MathiasHi/OPENCHESSBOARD_WiFi/schematic/Chessboard/Chessboard_top.jpg

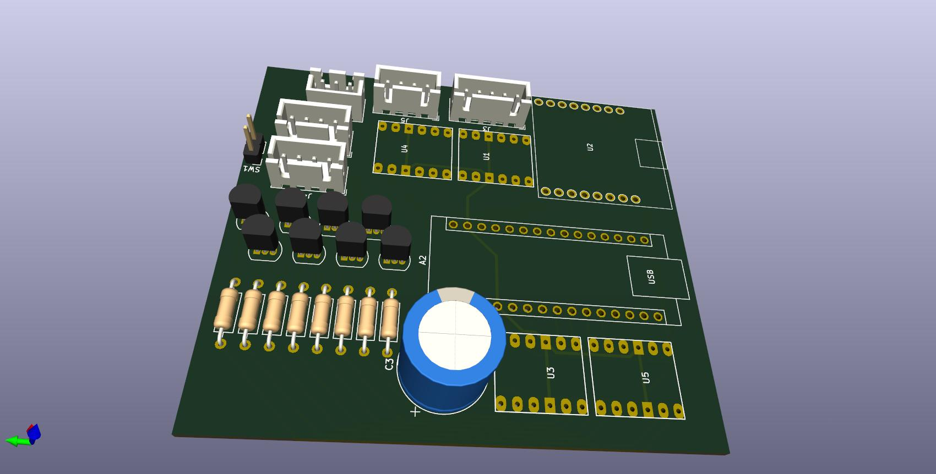
schematic/Chessboard/Chessboard_top.jpg
