MathiasHi/OPENCHESSBOARD_WiFi/schematic/Chessboard/Chessboard_bottom.jpg

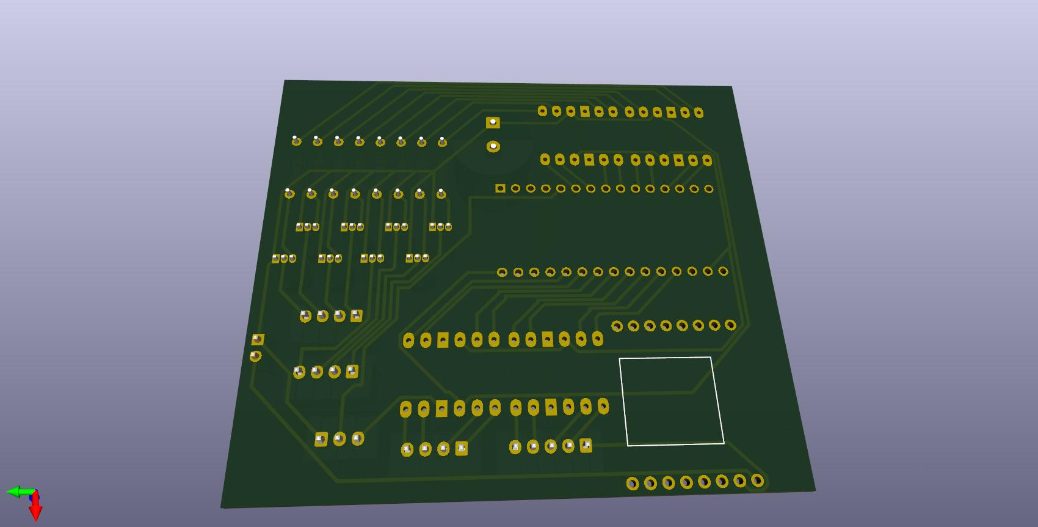
schematic/Chessboard/Chessboard_bottom.jpg
