MathiasHi/OPENCHESSBOARD_WiFi/schematic/ChessfieldLeftIn/Chessfield.kicad_pcb

## KiCad design schematic/ChessfieldLeftIn/Chessfield.kicad_pcb (2025-10-26)

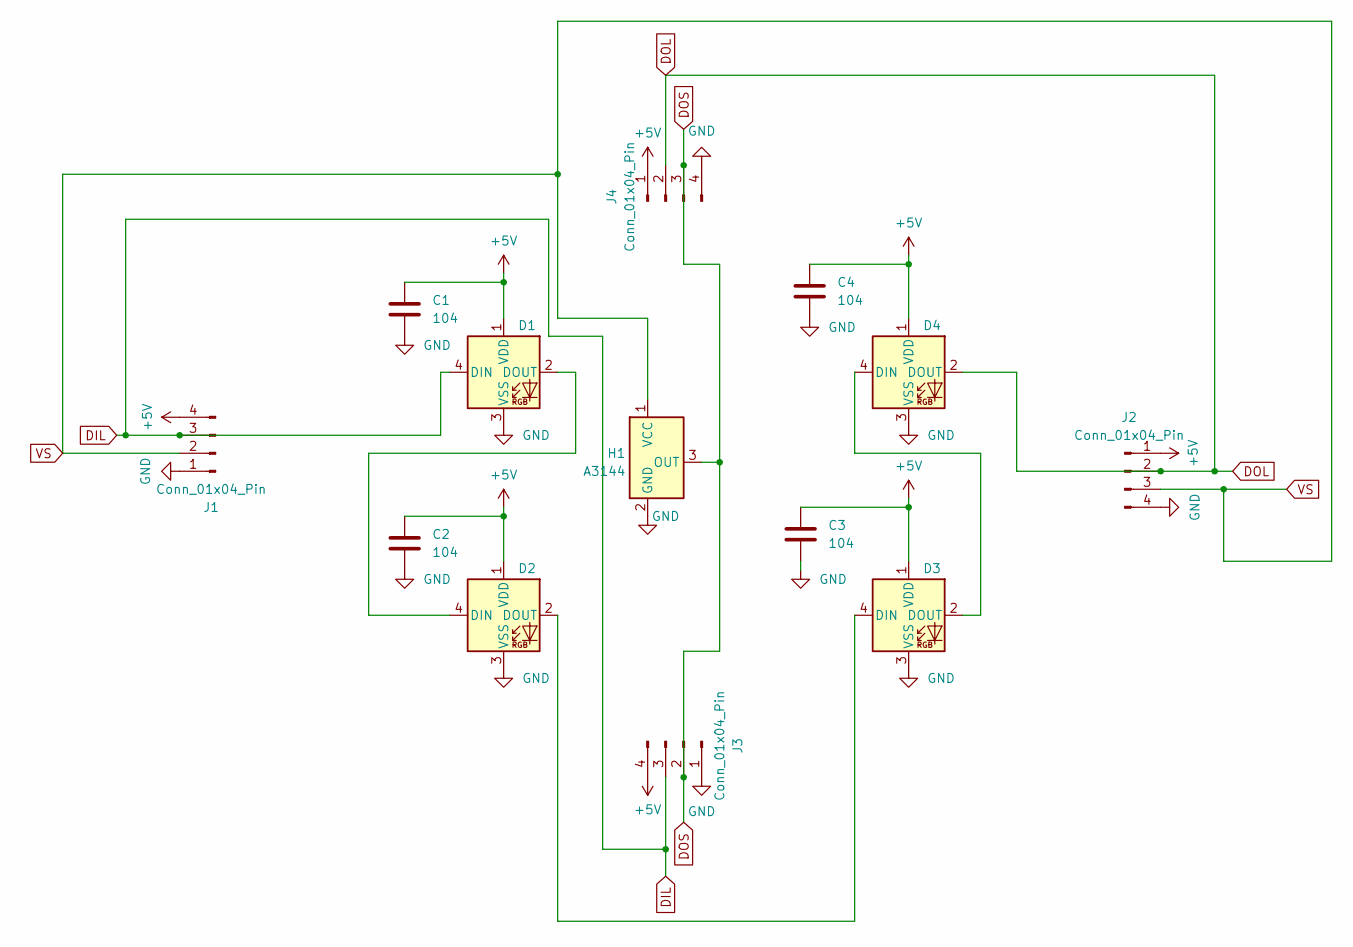
[picture p3: schematic Chessfield.kicad_sch]

Parts:
C1, C2, C3, C4: 104; C_0603_1608Metric_Pad1.08x0.95mm_HandSolder
D1, D2, D3, D4: WS2812B; LED_WS2812B_PLCC4_5.0x5.0mm_P3.2mm
H1: A3144; TO-92_Inline_Horizontal1
J1, J2, J3, J4: Conn_01x04_Pin; PinHeader_1x04_P2.54mm_Horizontal

Connections:
+5V: C1.1, C2.1, C3.1, C4.1, D1.1 (VDD), D2.1 (VDD), D3.1 (VDD), D4.1 (VDD), J1.4, J2.1, J3.4, J4.1
DIL: D1.4 (DIN), J1.3, J3.3
DOL: D4.2 (DOUT), J2.2, J4.2
DOS: H1.3 (OUT), J3.2, J4.3
GND: C1.2, C2.2, C3.2, C4.2, D1.3 (VSS), D2.3 (VSS), D3.3 (VSS), D4.3 (VSS), H1.2 (GND), J1.1, J2.4, J3.1, J4.4
unnamed: D1.2 (DOUT), D2.4 (DIN)
unnamed: D2.2 (DOUT), D3.4 (DIN)
unnamed: D3.2 (DOUT), D4.4 (DIN)
VS: H1.1 (VCC), J1.2, J2.3

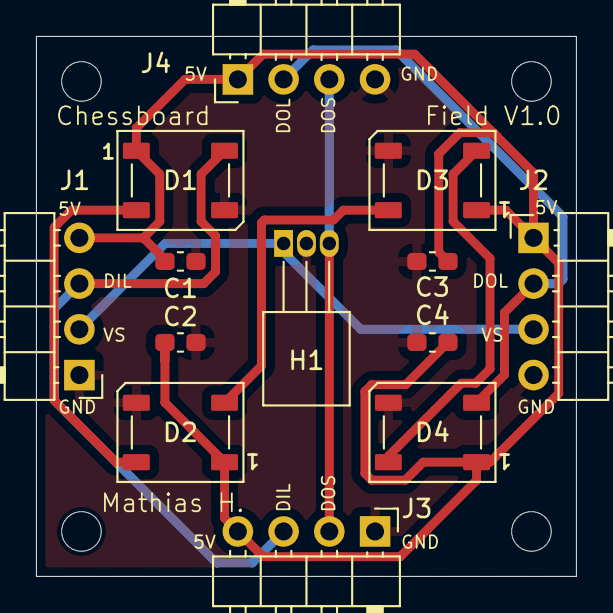
[picture p4: board Chessfield.kicad_pcb from above]

Board: 2 copper layers, 30.0 x 30.0 mm, 13 parts (0 on the bottom side), 9 nets.
