MathiasHi/OPENCHESSBOARD_WiFi/schematic/Chessboard/Chessboard.kicad_pcb

## KiCad design schematic/Chessboard/Chessboard.kicad_pcb (2025-10-26)

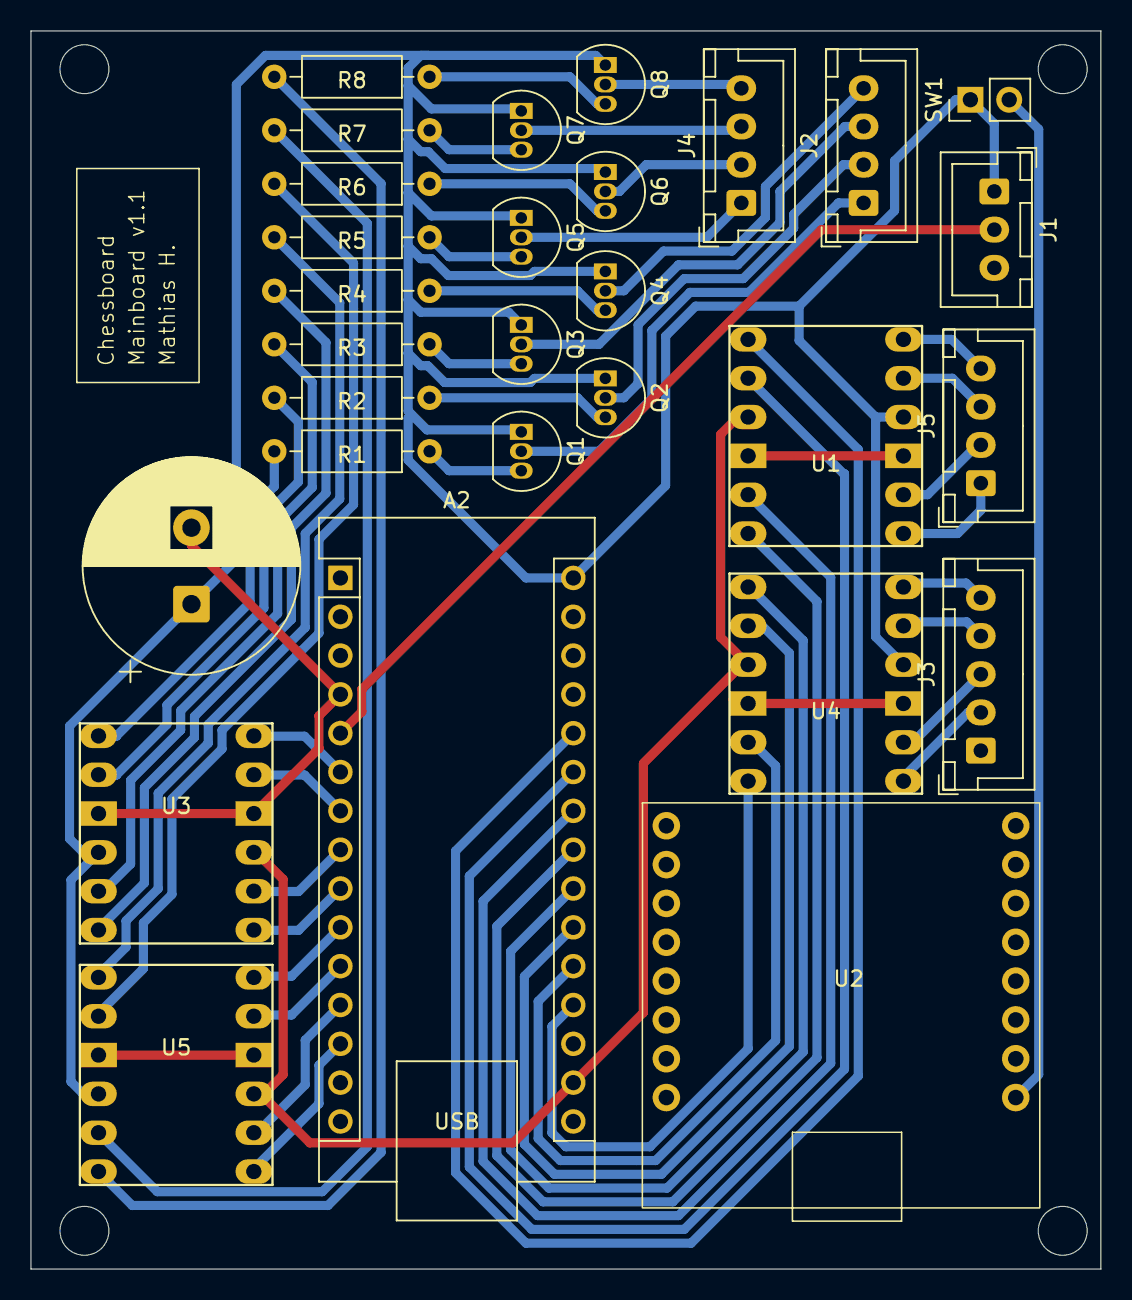
[picture p5: board Chessboard.kicad_pcb from above]

Board: 2 copper layers, 70.0 x 81.0 mm, 29 parts (0 on the bottom side), 53 nets.

Parts:
A2: Arduino_Nano_ESP32; Arduino_Nano
C3: C_Polarized; CP_Radial_D14.0mm_P5.00mm
J1: LED; JST_XH_B3B-XH-A_1x03_P2.50mm_Vertical
J2, J4: VOUT; JST_XH_B4B-XH-A_1x04_P2.50mm_Vertical
J3: Data; JST_XH_B5B-XH-A_1x05_P2.50mm_Vertical
J5: Data; JST_XH_B4B-XH-A_1x04_P2.50mm_Vertical
Q1, Q2, Q3, Q4, Q5, Q6, Q7, Q8: BC640; TO-92_Inline
R1, R2, R3, R4, R5, R6, R7, R8: 2K2; R_Axial_DIN0207_L6.3mm_D2.5mm_P10.16mm_Horizontal
SW1: SW_SPST; PinHeader_1x02_P2.54mm_Vertical
U1, U3, U4, U5: Logic Level Shifter; LogicLevel4ch
U2: Batterie Shield; D1_mini_board

Connections:
+3V3: A2.17 (3V3), U1.10 (LV), U3.10 (LV), U4.10 (LV), U5.10 (LV)
+5V: A2.30 (VIN), C3.1, J1.1, Q1.1 (E), Q2.1 (E), Q3.1 (E), Q4.1 (E), Q5.1 (E), Q6.1 (E), Q7.1 (E), Q8.1 (E), SW1.1 (A), U1.3 (HV), U3.3 (HV), U4.3 (HV), U5.3 (HV)
/LED_ROW_1_2/LED_Data: A2.5 (D2), J1.2
/Sensor/D1: J5.1, U1.6 (HV4)
/Sensor/D2: J5.2, U1.5 (HV3)
/Sensor/D3: J5.3, U1.2 (HV2)
/Sensor/D4: J5.4, U1.1 (HV1)
/Sensor/D5: J3.2, U4.6 (HV4)
/Sensor/D6: J3.3, U4.5 (HV3)
/Sensor/D7: J3.4, U4.2 (HV2)
/Sensor/D8: J3.5, U4.1 (HV1)
/Sensor/VS1: J2.1, Q1.2 (C)
/Sensor/VS2: J2.2, Q2.2 (C)
/Sensor/VS3: J2.3, Q3.2 (C)
/Sensor/VS4: J2.4, Q4.2 (C)
/Sensor/VS5: J4.1, Q5.2 (C)
/Sensor/VS6: J4.2, Q6.2 (C)
/Sensor/VS7: J4.3, Q7.2 (C)
/Sensor/VS8: J4.4, Q8.2 (C)
GND: A2.4 (GND), A2.29 (GND), C3.2, J1.3, J3.1, U1.4 (GND), U1.9 (GND), U2.2 (GND), U3.4 (GND), U3.9 (GND), U4.4 (GND), U4.9 (GND), U5.4 (GND), U5.9 (GND)
unnamed: A2.19 (A0), U4.7 (LV4)
unnamed: A2.20 (A1), U4.8 (LV3)
unnamed: A2.21 (A2), U4.11 (LV2)
unnamed: A2.22 (A3), U4.12 (LV1)
unnamed: A2.25 (A6), U1.11 (LV2)
unnamed: A2.26 (A7), U1.12 (LV1)
unnamed: A2.6 (D3), U3.7 (LV4)
unnamed: A2.7 (D4), U3.8 (LV3)
unnamed: A2.8 (D5), U3.11 (LV2)
unnamed: A2.9 (D6), U3.12 (LV1)
unnamed: A2.10 (D7), U5.7 (LV4)
unnamed: A2.11 (D8), U5.8 (LV3)
unnamed: A2.12 (D9), U5.11 (LV2)
unnamed: A2.13 (D10/CS), U5.12 (LV1)
unnamed: A2.24 (SCL/A5), U1.8 (LV3)
unnamed: A2.23 (SDA/A4), U1.7 (LV4)
unnamed: Q1.3 (B), R1.1
unnamed: Q2.3 (B), R2.1
unnamed: Q3.3 (B), R3.1
unnamed: Q4.3 (B), R4.1
unnamed: Q5.3 (B), R5.1
unnamed: Q6.3 (B), R6.1
unnamed: Q7.3 (B), R7.1
unnamed: Q8.3 (B), R8.1
unnamed: SW1.2 (B), U2.1 (5V)
unnamed: R4.2, U3.1 (HV1)
unnamed: R3.2, U3.2 (HV2)
unnamed: R2.2, U3.5 (HV3)
unnamed: R1.2, U3.6 (HV4)
unnamed: R8.2, U5.1 (HV1)
unnamed: R7.2, U5.2 (HV2)
unnamed: R6.2, U5.5 (HV3)
unnamed: R5.2, U5.6 (HV4)
