MathiasHi/OPENCHESSBOARD_WiFi/src/lichess_client.h

#pragma once
#include "openchessboard.h"
#include <ArduinoJson.h>

extern bool postMove(WiFiClientSecure  &client, String move);
extern void getStream(WiFiClientSecure  &client);
extern void disableClient(WiFiClientSecure  &client);
extern void getGameID(WiFiClientSecure  &client);
extern void postNewGame(WiFiClientSecure  &client, String board_gameMode);
extern char* catchResponseFromClient(WiFiClientSecure &client);
extern bool parseJsonResponse(const char* response, JsonDocument& doc);
