MathiasHi/OPENCHESSBOARD_WiFi/(commit log)

2025-03-31 Use led strip
2025-04-01 get hall inputs as intended
2025-04-26 use neo pixel lib, change led orientation
2025-07-02 add schematic. use digital sensors
    [Chessboard.csv, Chessboard.kicad_pcb, Chessboard.kicad_sch]
2025-07-03 fix Stream Buffer issue
    [board_driver.cpp]
2025-09-28 edit schematics
    [Chessboard.kicad_pcb, Chessboard.kicad_sch, LED.kicad_sch, Sensor.kicad_sch]
2025-10-04 routen and gerber files
    [Chessboard-B_Cu.gbr, Chessboard-B_Mask.gbr, Chessboard-B_Paste.gbr, Chessboard-B_Silkscreen.gbr, Chessboard-Edge_Cuts.gbr, Chessboard-F_Cu.gbr, Chessboard-F_Mask.gbr, Chessboard-F_Paste.gbr]
2025-10-04 export schematics and images
2025-10-05 finish Mainboard design
    [Chessboard-B_Cu.gbr, Chessboard-B_Mask.gbr, Chessboard-B_Paste.gbr, Chessboard-B_Silkscreen.gbr, Chessboard-Edge_Cuts.gbr, Chessboard-F_Cu.gbr, Chessboard-F_Mask.gbr, Chessboard-F_Paste.gbr]
2025-10-05 add chessfield schematics
    [Chessfield.kicad_pcb, Chessfield.kicad_sch]
2025-10-05 update chesssfield
    [Chessfield.kicad_pcb, Chessfield.kicad_sch]
2025-10-06 finish chessfield
    [Chessfield-B_Cu.gbr, Chessfield-B_Mask.gbr, Chessfield-B_Paste.gbr, Chessfield-B_Silkscreen.gbr, Chessfield-Edge_Cuts.gbr, Chessfield-F_Cu.gbr, Chessfield-F_Mask.gbr, Chessfield-F_Paste.gbr]
2025-10-06 fix chessfield schematics
    [Chessfield-B_Cu.gbr, Chessfield-B_Mask.gbr, Chessfield-B_Paste.gbr, Chessfield-B_Silkscreen.gbr, Chessfield-Edge_Cuts.gbr, Chessfield-F_Cu.gbr, Chessfield-F_Mask.gbr, Chessfield-F_Paste.gbr]
2025-10-26 add left and right input field
    [Chessboard-B_Cu.gbr, Chessboard-B_Mask.gbr, Chessboard-B_Paste.gbr, Chessboard-B_Silkscreen.gbr, Chessboard-Edge_Cuts.gbr, Chessboard-F_Cu.gbr, Chessboard-F_Mask.gbr, Chessboard-F_Paste.gbr]
2025-10-26 Fix move input, only wen piece put down
    [board_driver.cpp]
2025-12-06 Remove Plug on Top, fixes for new Hardware
    [OPENCHESSBOARD_WiFi.ino, board_driver.cpp, openchessboard.h]
